sudo-ellipsis/PAST-onboarding/Deliverables/images/image-20.png

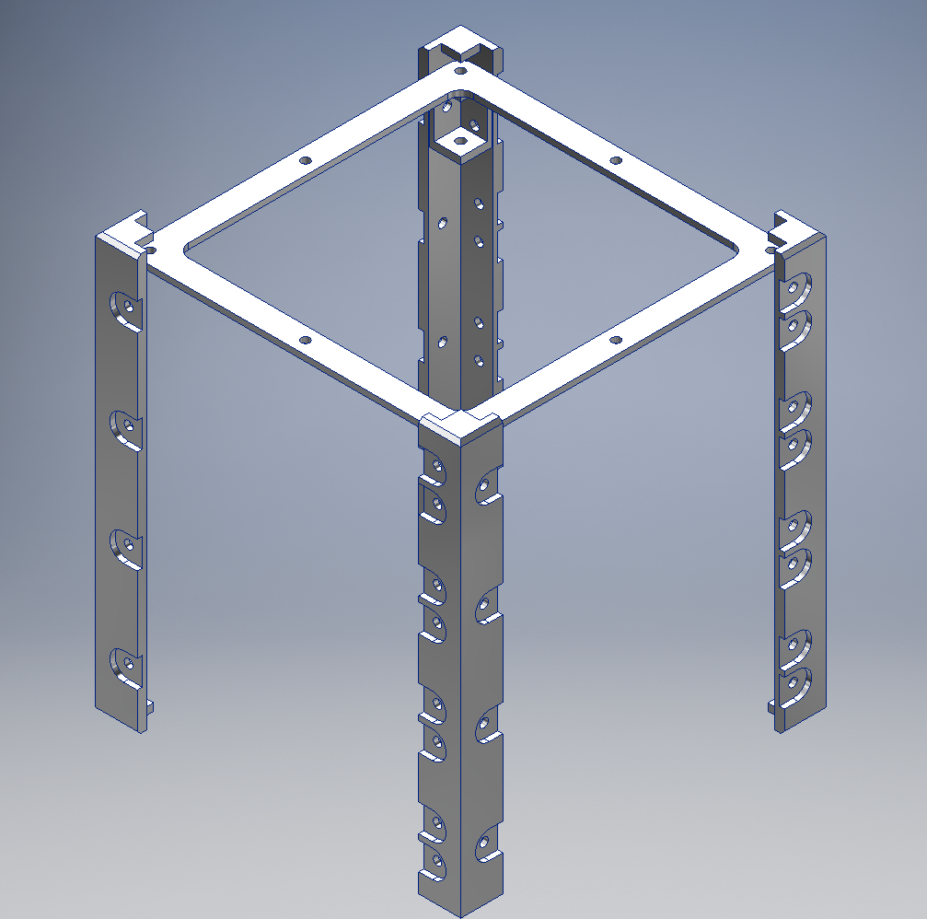
Deliverables/images/image-20.png
