sudo-ellipsis/PAST-onboarding/Deliverables/images/image-21.png

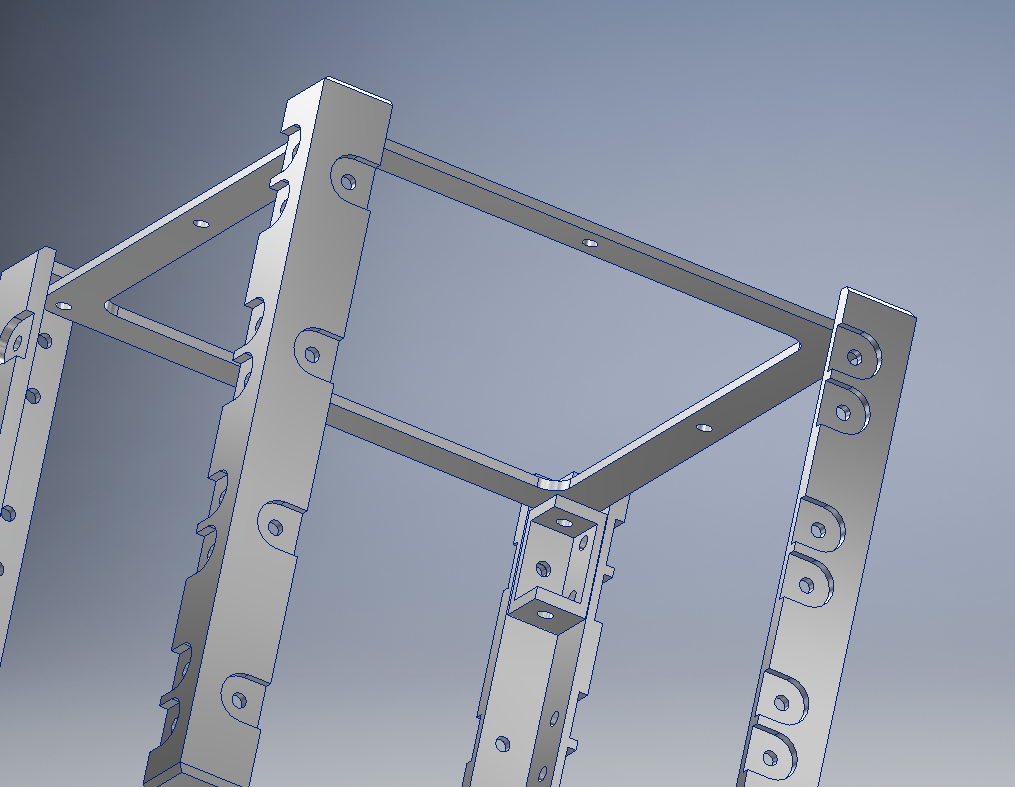
Deliverables/images/image-21.png
