sudo-ellipsis/PAST-onboarding/Deliverables/images/image-22.png

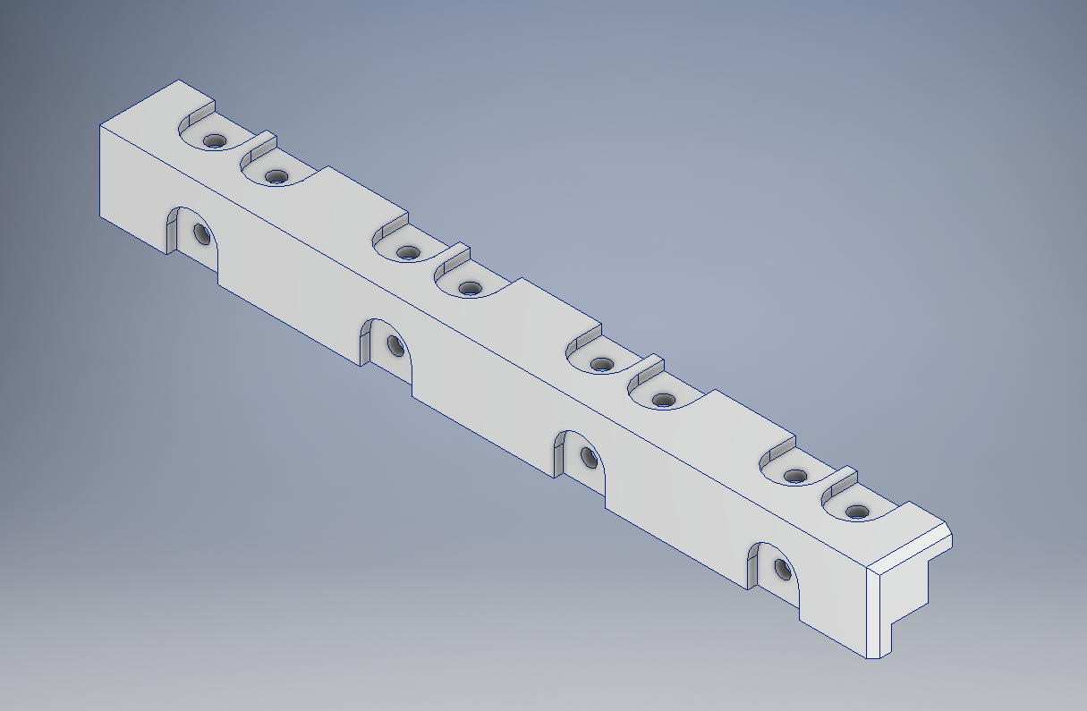
Deliverables/images/image-22.png
