sudo-ellipsis/PAST-onboarding/Deliverables/7. 3D Prints/StructuralFrame.stl

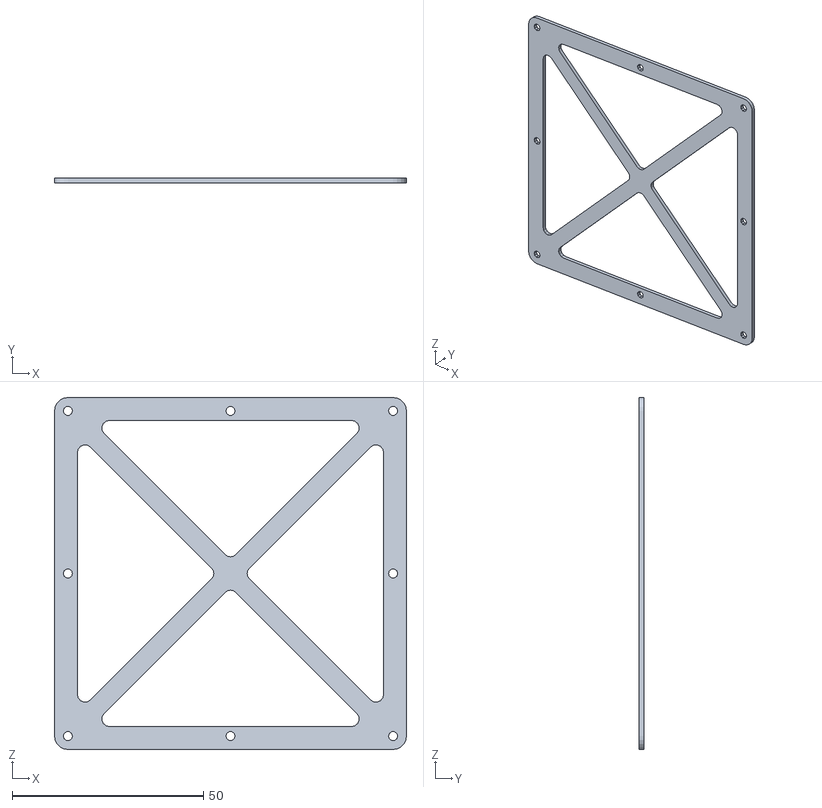
[picture p18: CAD file, 2025-10-01]
Deliverables/7. 3D Prints/StructuralFrame.stl
92.0 x 1.20 x 92.0
