sudo-ellipsis/PAST-onboarding/Deliverables/7. 3D Prints/RailFrameBracket.stl

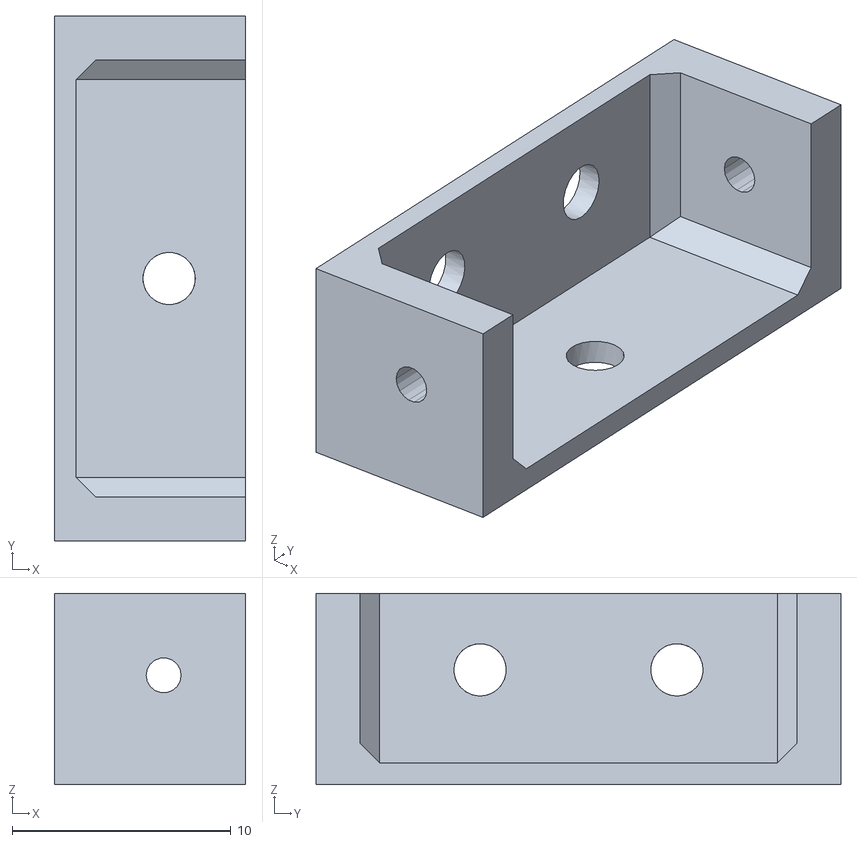
[picture p19: CAD file, 2025-10-01]
Deliverables/7. 3D Prints/RailFrameBracket.stl
8.75 x 24.0 x 8.75
