sudo-ellipsis/PAST-onboarding/Deliverables/7. 3D Prints/Horizontal Bar.stl

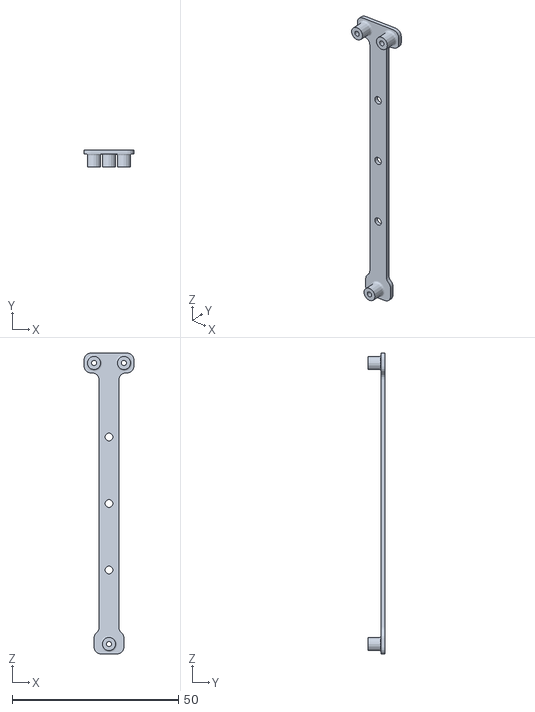
[picture p20: CAD file, 2025-10-01]
Deliverables/7. 3D Prints/Horizontal Bar.stl
15.0 x 5.20 x 90.5
