sudo-ellipsis/PAST-onboarding/Deliverables/7. 3D Prints/Rail.stl

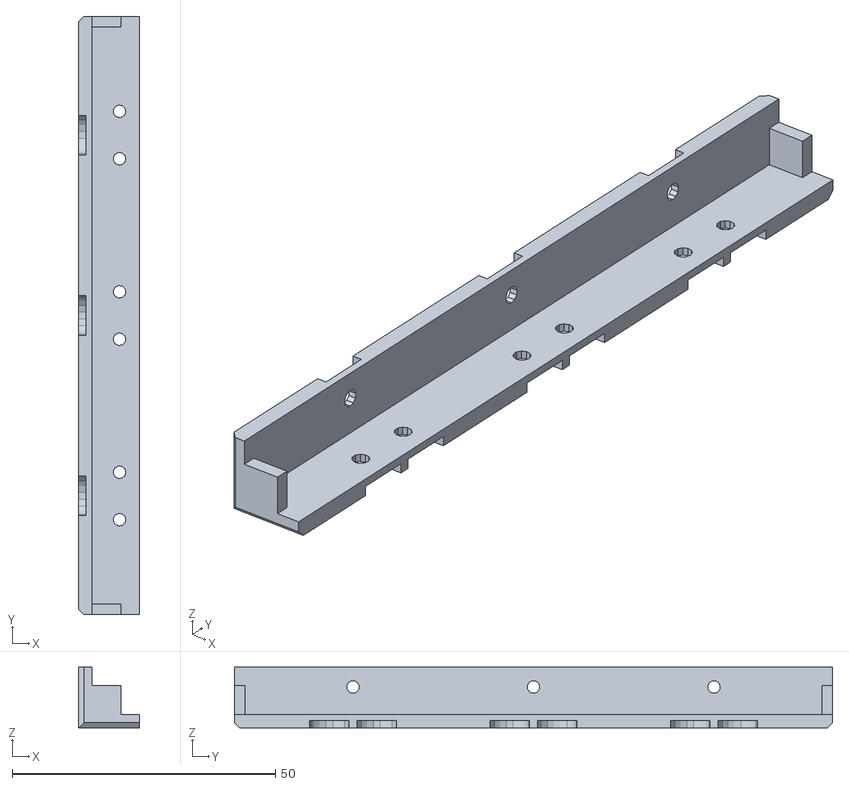
[picture p21: CAD file, 2025-10-01]
Deliverables/7. 3D Prints/Rail.stl
11.5 x 113.5 x 11.5
