sudo-ellipsis/PAST-onboarding/(list of files, cad)

Other CAD files:
Deliverables/6. Drawings/RailFrameBracket.dwg
Deliverables/6. Drawings/PCB Mounting Diagram.dwg
Deliverables/6. Drawings/StructuralFrame.dwg
Deliverables/6. Drawings/Rail.dwg
Deliverables/6. Drawings/Horizontal Bar.dwg
