sudo-ellipsis/PAST-onboarding/Deliverables/7. 3D Prints/G2KksVeaIAAgAx6.jpg

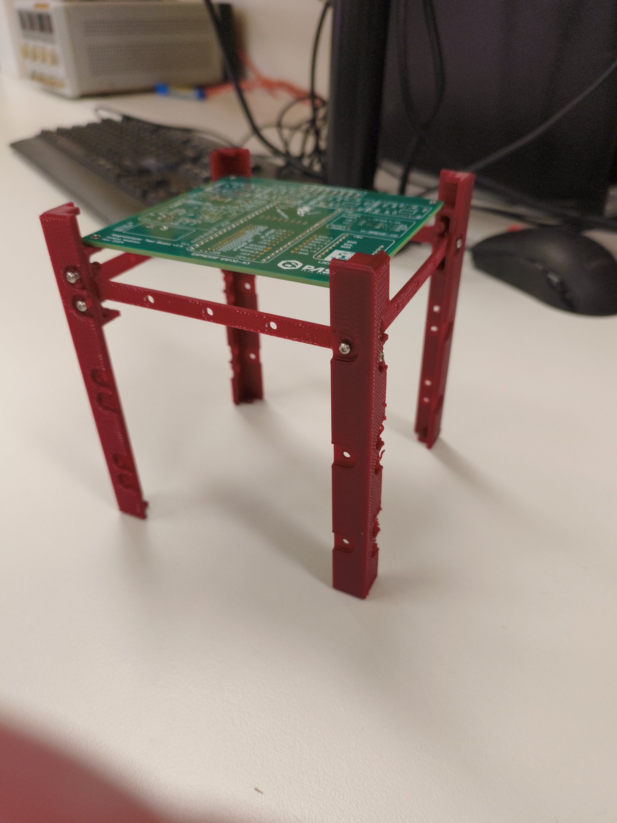
Deliverables/7. 3D Prints/G2KksVeaIAAgAx6.jpg
