sudo-ellipsis/PAST-onboarding/Deliverables/7. 3D Prints/G2KksX2bcAAfQoo.jpg

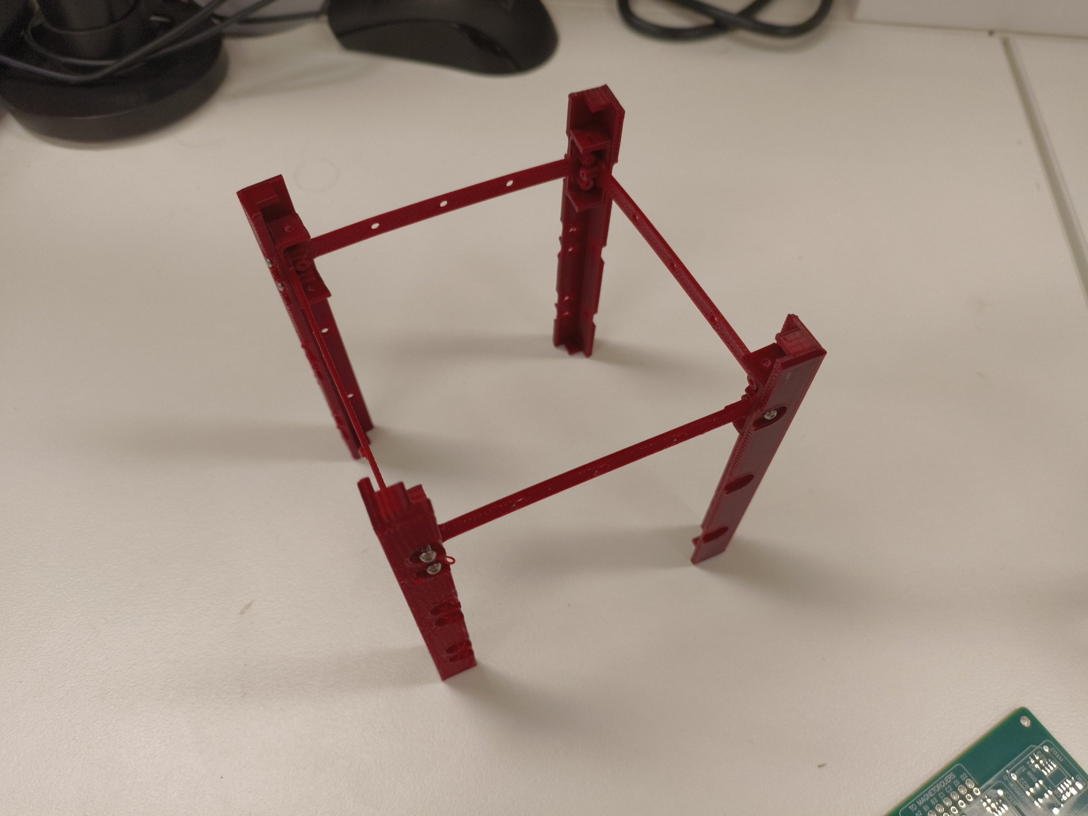
Deliverables/7. 3D Prints/G2KksX2bcAAfQoo.jpg
