sudo-ellipsis/PAST-onboarding/Deliverables/7. 3D Prints/G2KksZsbUAAhhZF.jpg

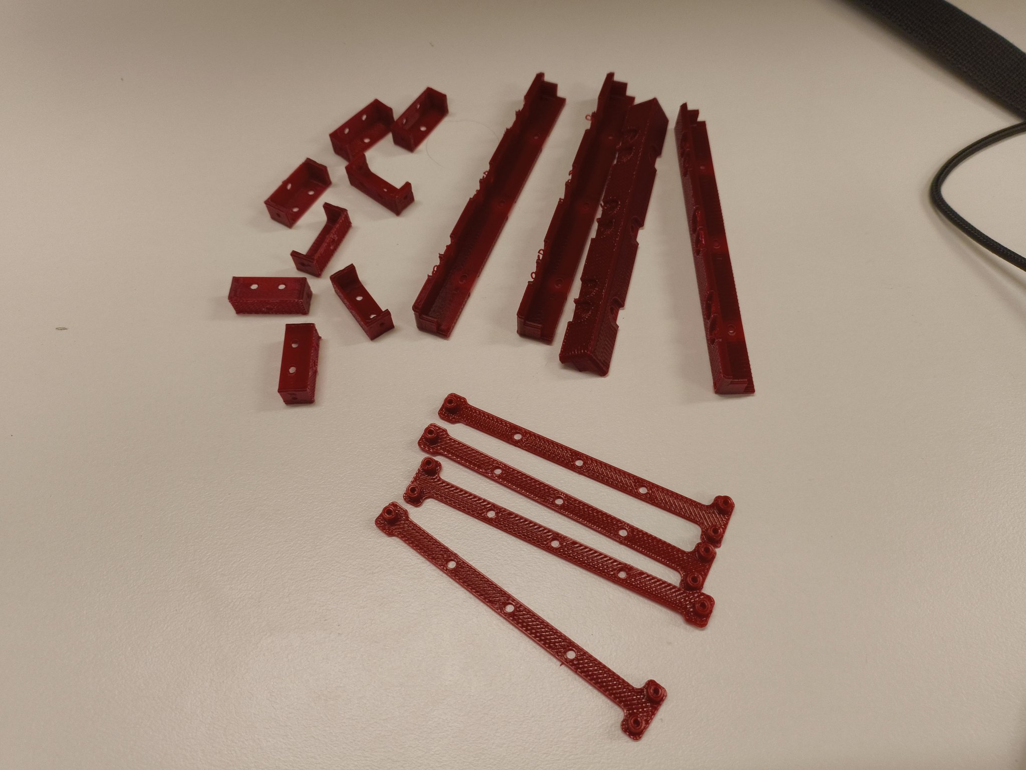
Deliverables/7. 3D Prints/G2KksZsbUAAhhZF.jpg
