sudo-ellipsis/PAST-onboarding/Logbook.docx

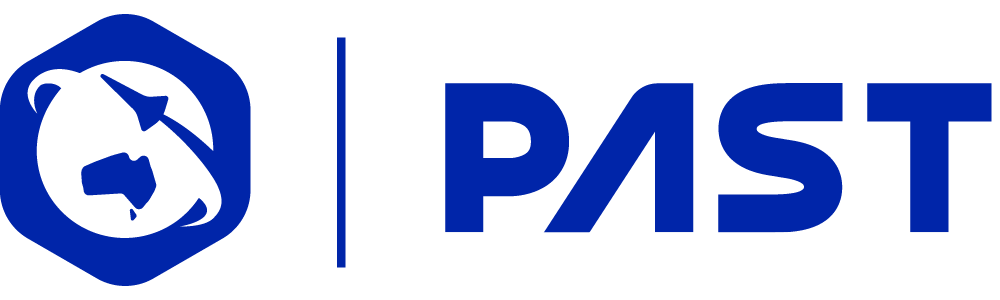
[picture p25: figure]

Connor Major

20755762@student.curtin.edu.au

Logbook

## Foreword

Previously, I attempted to achieve this project in Semester 1, 2025 for PAST onboarding. However, I did not achieve sufficient milestones for my work to be accepted. I am re-applying, however, as I consider this project challenging and fulfilling and failed to achieve most of the significant design, I am redoing this project. Milestones 1 & 2 have been kept as they are primarily research documents, however milestone 3 has been entirely abandoned with a new concept design.

## Work Completed

Date | Week | Time | Work Accomplished

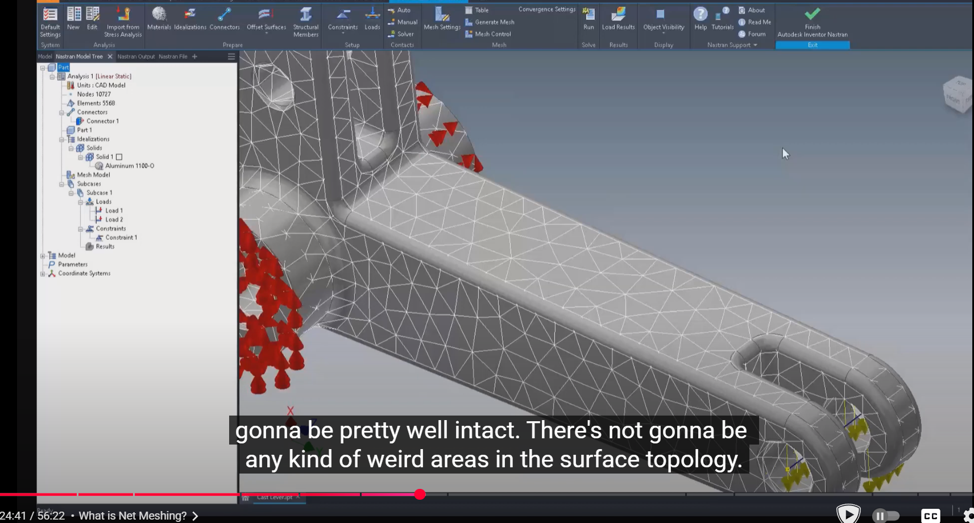
[picture p26: figure]

13/8/25 | 0 | 2 hrs | - Installed Inventor NASTRAN - Joined PAST discord server - Watched youtube videos about inventor NASTRAN and the analysis process. Learned how to work with parts and assemblies and interpret simulation data - Reread my previous notes on JAXA requirements and concept designs
20/8/25 | 1 | 2 hrs | - Made logbook document and wrote a foreword - Revisited previous draft design concepts and cleared out old concept designs to make way for new ones - Attended session and took quiz - Researched manufacturers for potential designs and found JLCCNC and Xometry - Researched precision metal bending
22/8/25 | 1 | 3 hrs | - Came up with new concept design (#3) using CNC machined parts. While previous designs used bent metal parts, after researching the cost and quality of CNC machined parts, I determined that using some CNC parts would overall reduce manufacturing complexity as hand-bending metal precisely is far too complex for students to perform
27/8/25 | 2 | 2 hrs | Attended session - Researched bolts for the design. After asking Raph & Inde, I found that McMaster is preferred, and most designs used M2 or M3 bolts. - Learned about PAST PCB sizing and adjusted my concept design to meet PAST PCB sizing - Referenced JAXA clearances to update my design. I calculated the surface area percentage of my rails with recesses and adjusted the recess sizes to accommodate the required 75% by JAXA specification - Changed to 3 mounting points and larger brackets to allow for mounting ease and meet JAXA requirements
28/8/25 | 2 | 1 hrs | - Researched manufacturing methods for flat plate aluminum & the available aluminum 6061 sheets in Australia. Noted the allowable thicknesses for future concept design work. - While laser cutting allows fine precision, it isn’t suitable for thicker materials. Waterjets have rougher surface finishes, so they may need sanding - Researched satellite surface finishes and found that most materials need to be sanded or ground down.

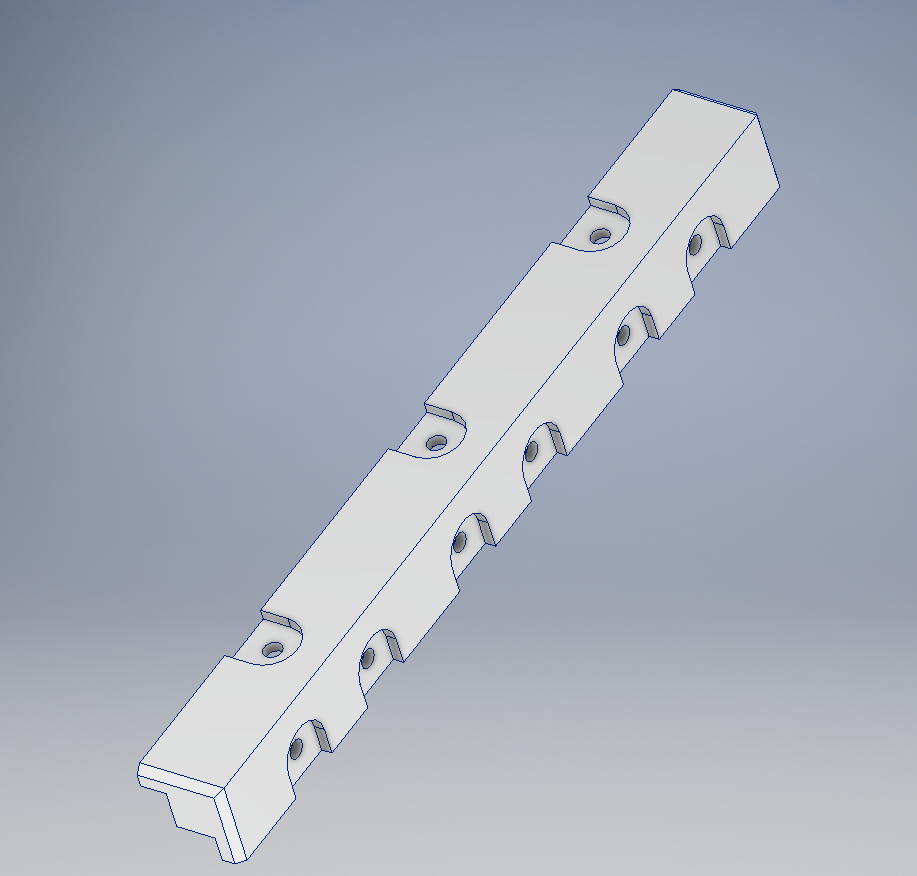
[picture p27: figure]
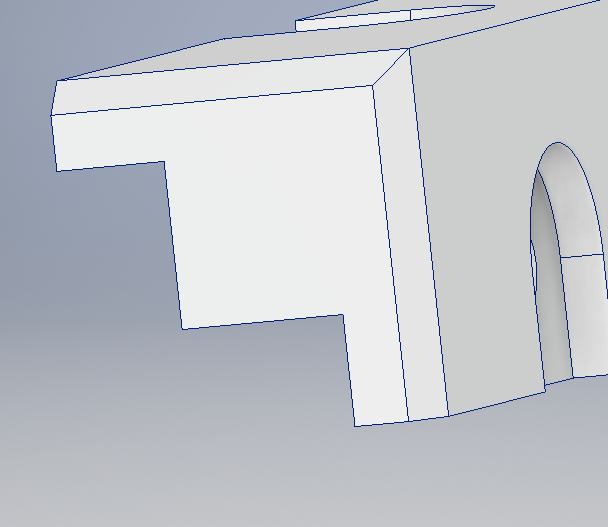
[picture p28: figure]

29/8/25 | 2 | 2 hrs | Updated my rail designs. Reduced mass by adding cutouts while maintaining a safety margin over JAXA minimum spec, thickened the bracket to increase stiffness and allow for extra recess after researching bolt head heights on McMaster, and added chamfers to both surfaces to meet the JAXA spec.

30/8/25

3

1 hrs

- Consulted with my AERO3001 professor (Robert) about CAD options for cubesats. Learned about the dimensional accuracy and tolerances of JLCCNC and competitors, as well as their quality. Learned that BINAR uses their work for non-critical test hardware and about the drawbacks and advantages of these shops
- Investigated the dimensional accuracy of JLCCNC and the range of surface finish / threading options they provide to drive design
- Researched existing cubesat designs from both COTS providers (both websites and youtube) as well as student designs to gain an understanding of general concepts in cubesat design in terms of rough dimensions of components and general design trends

1/9/25 | 3 | 3 hrs | - Created and described 3 concept designs using what I learned about exsiting designs to base existing designs - Created a ranking system for my concept design - Listed pros and cons of each cubesat design - Selected my final design using my ranking system - Began modelling of concept design 3
| | | Learned to parametise designs Pdated Deliverable 3 with concept designs and detail Added H bars Began an assembly

## Final Design overview

Strengths
Weaknesses
Screenshots
Concept

## Final Design BoM

Part | Supplier | Cost | Link

## Deliverables completed

Deliverable | Status | Link
Deliverable 1: Design requirements | Finished in Sem 1 | https://github.com/sudo-ellipsis/PAST-onboarding/blob/main/Deliverables/1.%20JAXA%20Requirements.md
Deliverable 2: Cubesat structure review | Finished in Sem 1 | https://github.com/sudo-ellipsis/PAST-onboarding/blob/main/Deliverables/2.%20Cubesat%20Structures.md
Deliverable 3: Concept designs | Finished, Sem 2
Deliverable 4: Concept design CAD | Finished, Sem 2 | None
Deliverable 5: FEA | Not attempted | None
Deliverable 6: Technical drawings | Not attempted | None
Deliverable 7: 3D print | Not attempted | None

## Reflection

Connor Major| 20755762@student.curtin.edu.au
