sudo-ellipsis/PAST-onboarding/Deliverables/6. Drawings/pdf/Horizontal Bar.pdf

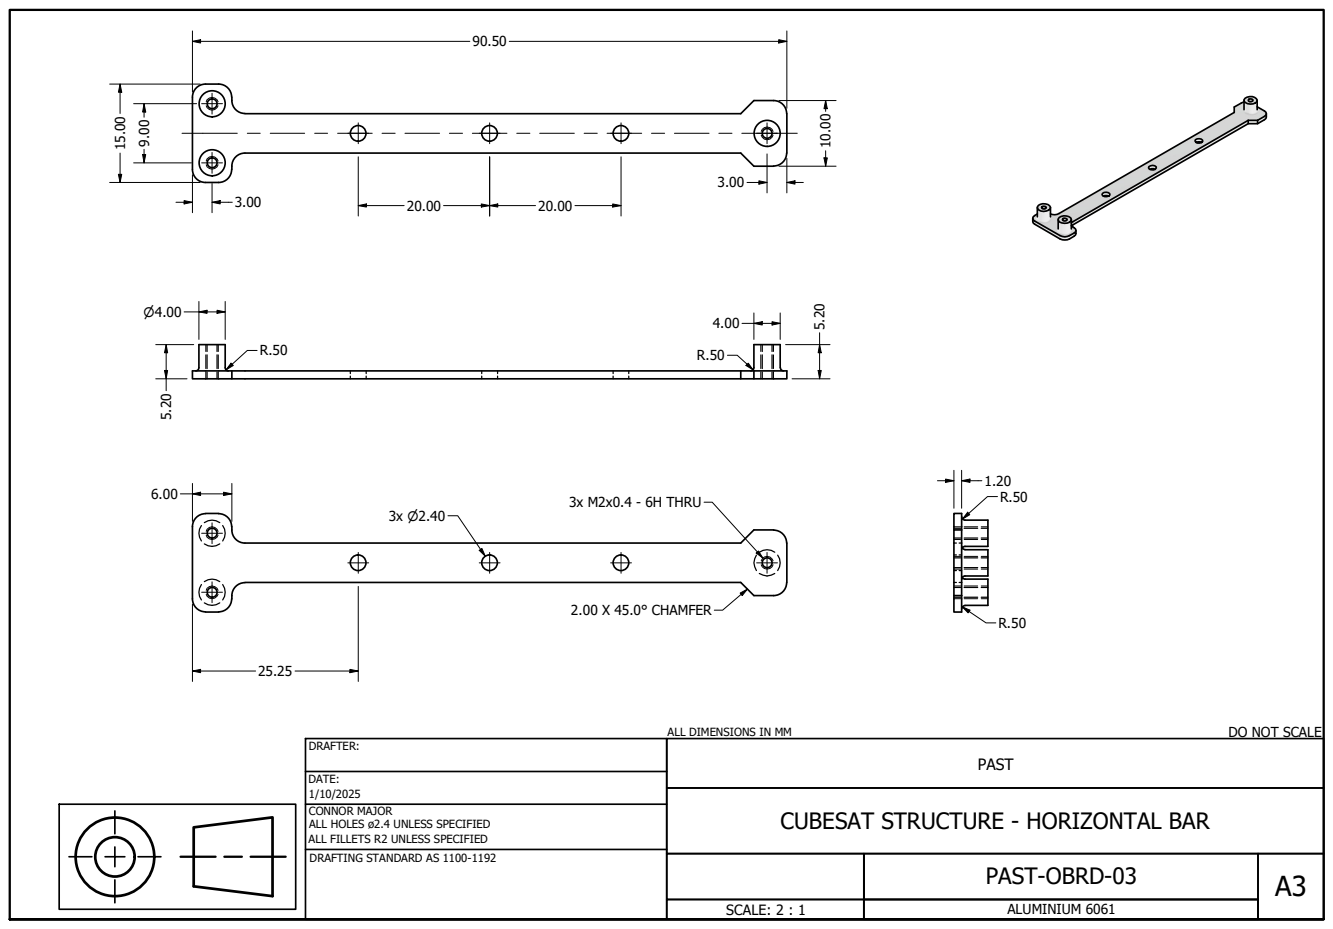
[picture p29: page 1]
ALL DIMENSIONS IN MM; DO NOT SCALE; 3x M2x0.4 - 6H THRU; 2.00 X 45.0° CHAMFER

DATE:
CONNOR MAJOR
ALL HOLES ø2.4 UNLESS SPECIFIED
ALL FILLETS R2 UNLESS SPECIFIED
DRAFTING STANDARD AS 1100-1192

CUBESAT STRUCTURE - HORIZONTAL BAR

PAST-OBRD-03 | A3

SCALE: 2 : 1 | ALUMINIUM 6061
