sudo-ellipsis/PAST-onboarding/Deliverables/6. Drawings/pdf/PCB Mounting Diagram.pdf

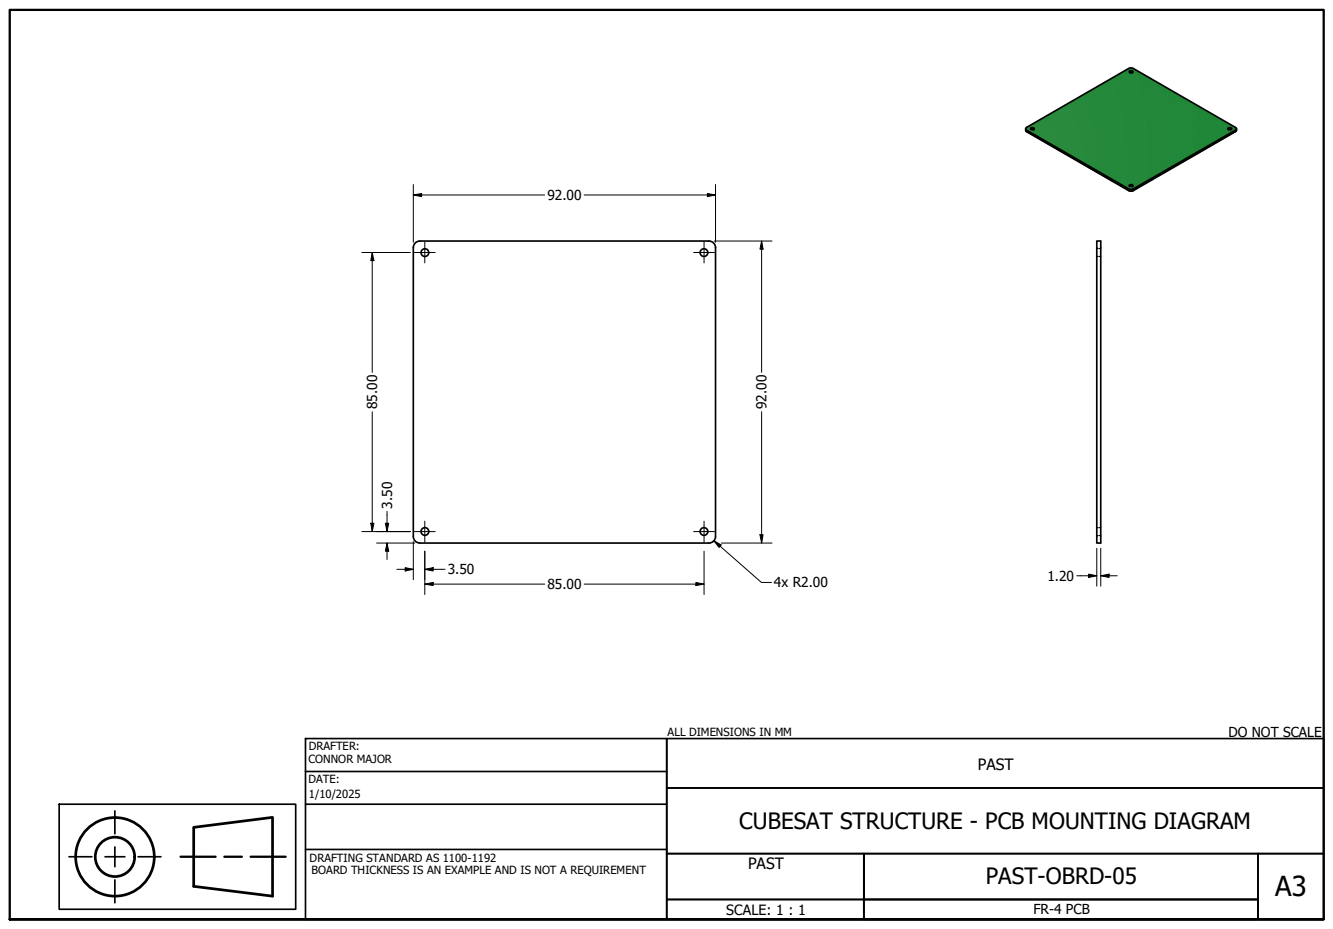
[picture p30: page 1]
ALL DIMENSIONS IN MM; DO NOT SCALE; CONNOR MAJOR

CUBESAT STRUCTURE - PCB MOUNTING DIAGRAM

DRAFTING STANDARD AS 1100-1192
BOARD THICKNESS IS AN EXAMPLE AND IS NOT A REQUIREMENT

PAST | PAST-OBRD-05 | A3

SCALE: 1 : 1 | FR-4 PCB
