sudo-ellipsis/PAST-onboarding/Deliverables/6. Drawings/pdf/Rail frame Bracket.pdf

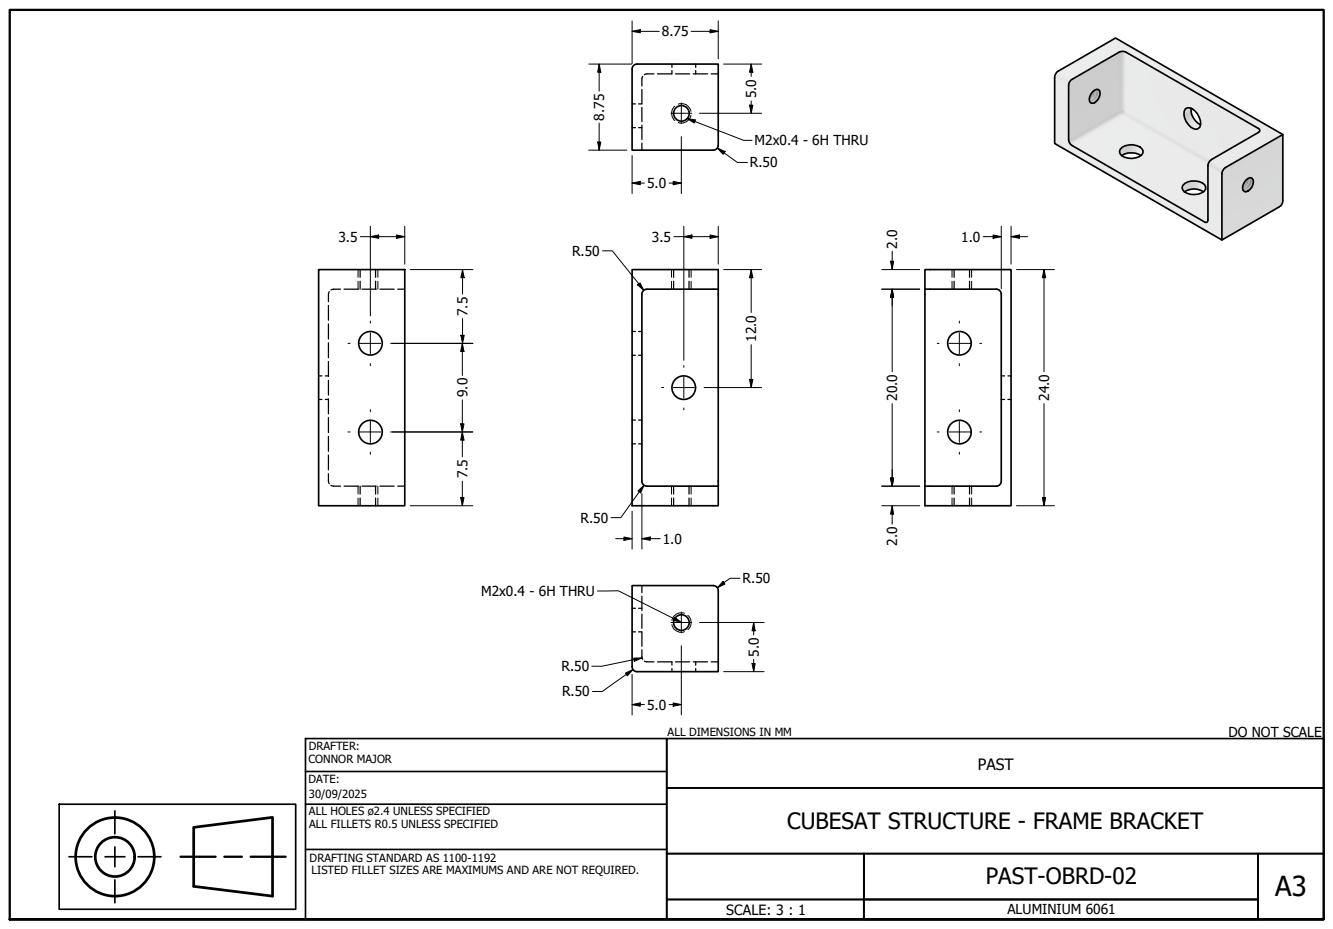
[picture p31: page 1]
ALL DIMENSIONS IN MM; DO NOT SCALE; M2x0.4 - 6H THRU

DRAFTER:
CONNOR MAJOR
DATE:
ALL HOLES ø2.4 UNLESS SPECIFIED
ALL FILLETS R0.5 UNLESS SPECIFIED

CUBESAT STRUCTURE - FRAME BRACKET

DRAFTING STANDARD AS 1100-1192
LISTED FILLET SIZES ARE MAXIMUMS AND ARE NOT REQUIRED.

PAST-OBRD-02 | A3

SCALE: 3 : 1 | ALUMINIUM 6061
