sudo-ellipsis/PAST-onboarding/Deliverables/6. Drawings/pdf/Rail.pdf

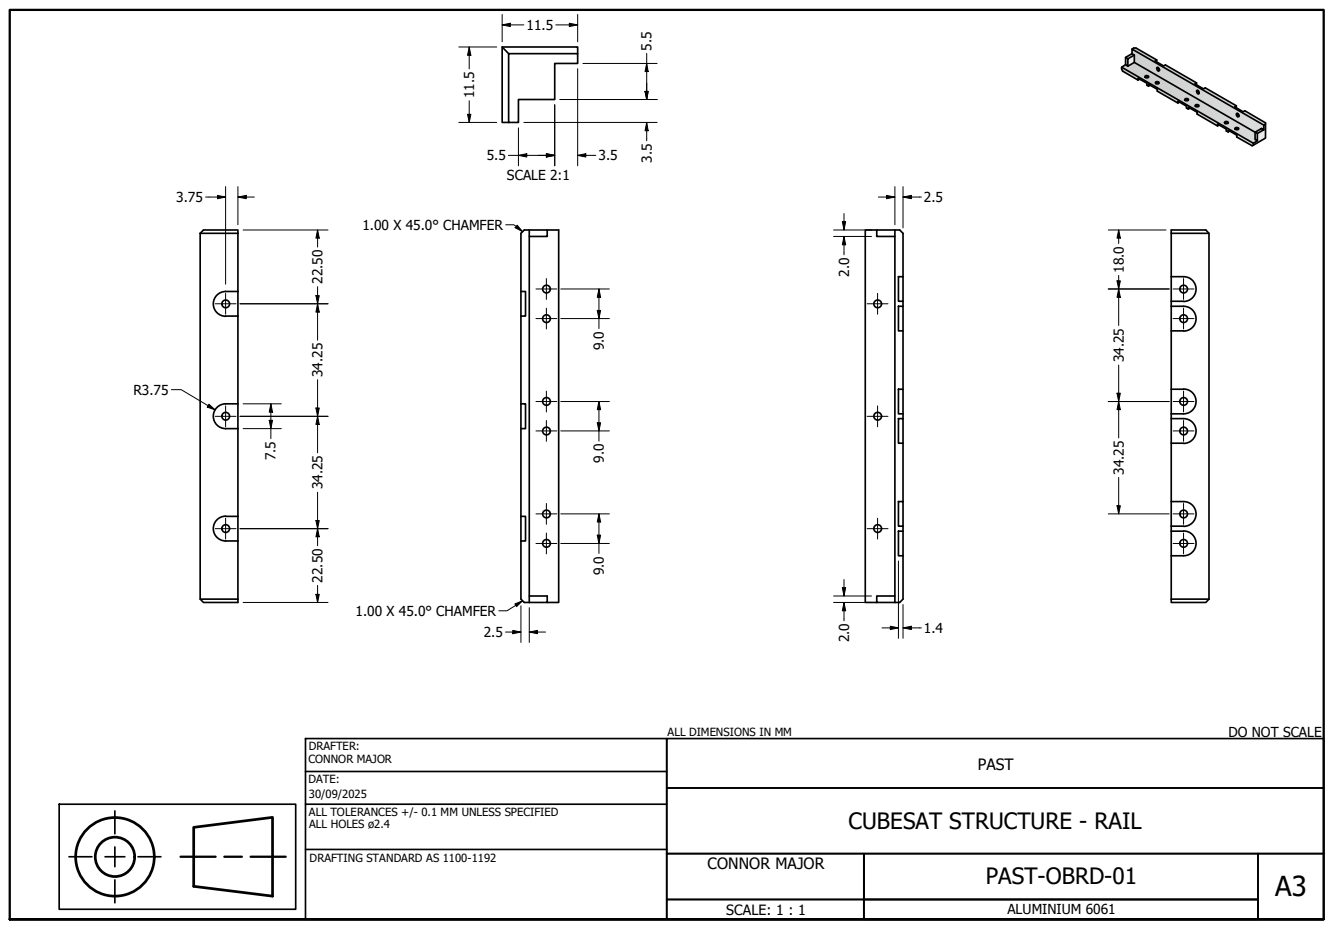
[picture p32: page 1]
ALL DIMENSIONS IN MM; DO NOT SCALE; SCALE 2:1; 1.00 X 45.0° CHAMFER

DRAFTER:
CONNOR MAJOR
DATE:
ALL TOLERANCES +/- 0.1 MM UNLESS SPECIFIED
ALL HOLES ø2.4

CUBESAT STRUCTURE - RAIL

DRAFTING STANDARD AS 1100-1192

CONNOR MAJOR | PAST-OBRD-01 | A3

SCALE: 1 : 1 | ALUMINIUM 6061
