sudo-ellipsis/PAST-onboarding/Deliverables/6. Drawings/pdf/Structural Frame.pdf

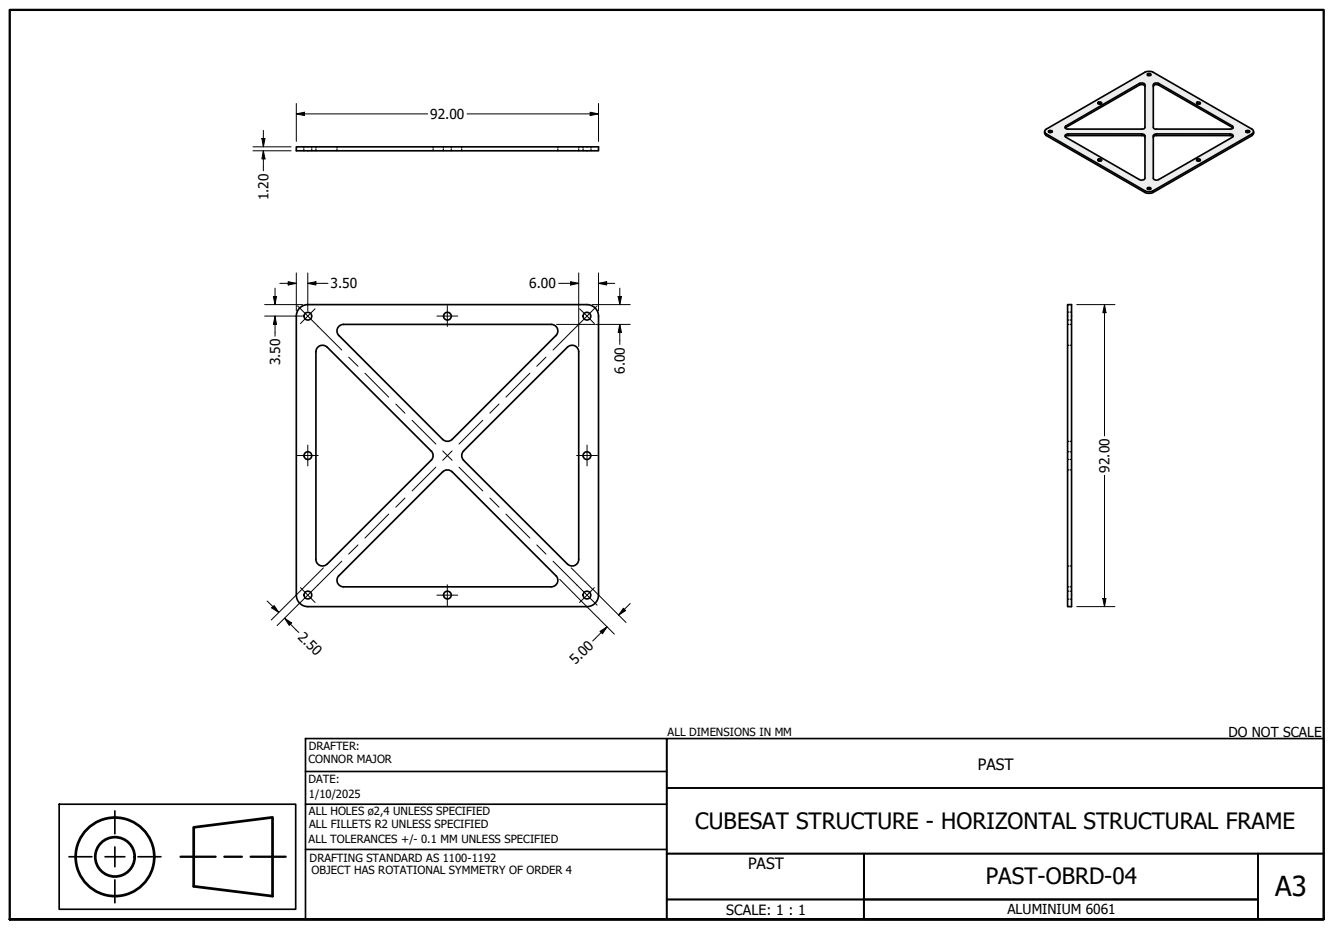
[picture p33: page 1]
ALL DIMENSIONS IN MM; DO NOT SCALE

DRAFTER:
CONNOR MAJOR
DATE:
ALL HOLES ø2,4 UNLESS SPECIFIED
ALL FILLETS R2 UNLESS SPECIFIED
ALL TOLERANCES +/- 0.1 MM UNLESS SPECIFIED
DRAFTING STANDARD AS 1100-1192
OBJECT HAS ROTATIONAL SYMMETRY OF ORDER 4

CUBESAT STRUCTURE - HORIZONTAL STRUCTURAL FRAME

PAST | PAST-OBRD-04 | A3

SCALE: 1 : 1 | ALUMINIUM 6061
