sudo-ellipsis/PAST-onboarding/(commit log)

2025-10-01 Deliverable 6
    [Horizontal Bar.dwg, PCB Mounting Diagram.dwg, Rail.dwg, RailFrameBracket.dwg, StructuralFrame.dwg]
2025-10-01 week 7
    [Horizontal Bar.dwg, PCB Mounting Diagram.dwg, Rail.dwg, RailFrameBracket.dwg, StructuralFrame.dwg]
2025-10-01 3d print files & results
    [Horizontal Bar.stl, Rail.stl, RailFrameBracket.stl, StructuralFrame.stl]
